Rogiel/ufrgs-instrumentacao-projeto/README.md

# ufrgs-instrumentacao-projeto
Relatório e outros conteúdos relacionados ao projeto final de Instrumentação
