Rogiel/ufrgs-instrumentacao-projeto/Resources/Images/Figuras.pptx

Dmáx

VINA_máx

0h2984

Rmáx

Vpontemáx

1.842mV

Tensão
de Saída
da Ponte

1.483V

Tmáx

119.4Ω

ΔR do
Pt100

Tensão
de Saída
do Amp.
de Instrum.
G=805

-1.823V

50°C

ΔT

ADC
14 bits
-5V a +5V

-10°C

Tmín

96.1Ω

Rmín

-2.265mV

Vpontemín

VINA_mín

0h1458

Dmín

Cadeia de medidas proposta – Termômetro

## Slide 2

Dmáx

VINA_máx

0h2978

Rmáx

Vpontemáx

1.9mV

Tensão
de Saída
da Ponte

1.476V

Tmáx

119.4Ω

ΔR do
Pt100

Tensão
de Saída
do Amp.
de Instrum.
G=805

-0.756V

50°C

ΔT

ADC
14 bits
-5V a +5V

Tmín

5°C

102.1Ω

Rmín

-0.8mV

Vpontemín

VINA_mín

0h1B2D

Dmín

Cadeia de medidas experimental – Termômetro

## Slide 3

Fiação para ligação ao circuito

Tubo plástico

Pt100

Fiação para ligação ao circuito

Silicone para isolamento

Pt100

Invólucro metálico

## Slide 4

Sensor
Efeito
Hall

Circuito
Condicionador

Filtro PB

ADC

Ferramenta de Instrumentação Virtual

## Slide 5

Pluvmáx

Cmáx

1115µs

Tmáx

8mm

Volmáx

203.6pF

ΔC do
Sensor

120mL

ΔVol

Período
do Oscilador

Índice
Pluviométrico

Volmín

0mL

3.416pF

Cmín

147µs

Tmín

Pluvmín

0mm

Cadeia de medidas proposta – Sensor de Nível

## Slide 6

Pluvmáx

Nmáx

8mm

Cmáx

117082 ciclos

Ciclosmáx

0.909

Volmáx

384.7pF

ΔC do
Sensor

120mL

ΔVol

Ciclos
do processador

Compensado
(Valor N)

Índice
Pluviométrico

Volmín

0mL

89.5pF

Cmín

35132 ciclos

Ciclosmín

0.004

Nmín

Pluvmín

0mm

Cadeia de medidas experimental – Sensor de Nível

## Slide 7

D=13.82cm

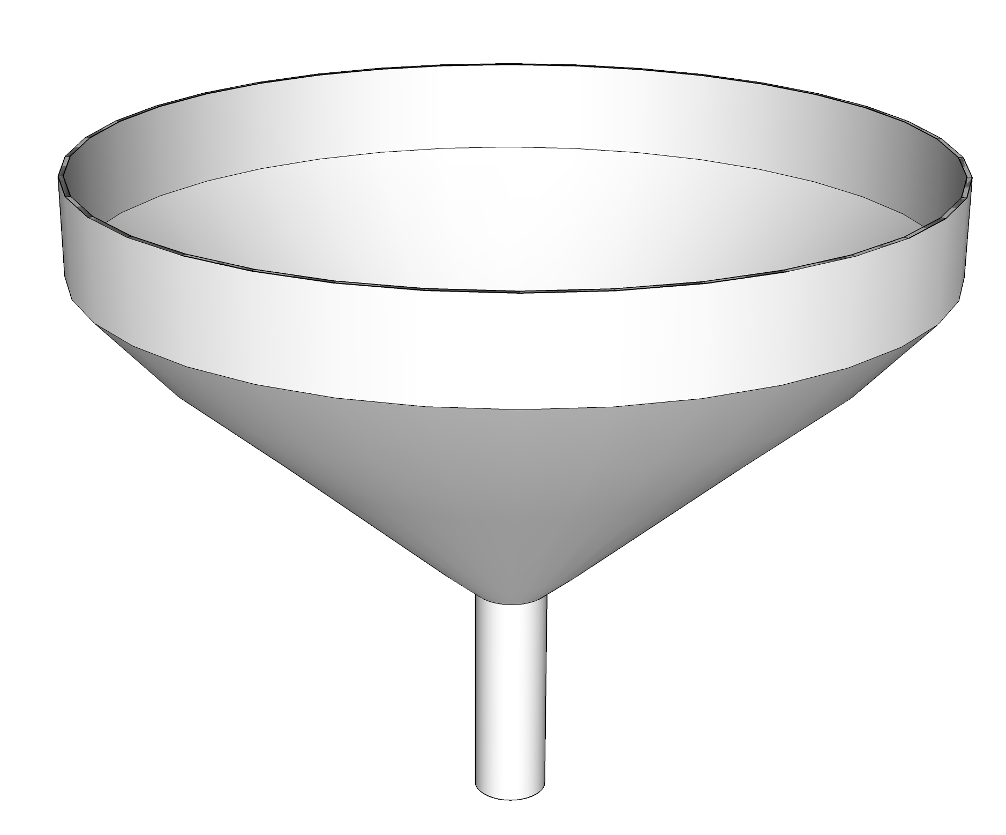
[picture p2: figure]

## Slide 8

RPMmáx

0h3FFF

ADC
14 bits
0V a +5V

Dmáx

RPMmáx

0h3FFF

ADC
14 bits
0V a +5V

Dmáx

Vmáx

796 RPM

Rotações
Da Estrutura

Vmáx

183.49 RPM

Rotações
Da Estrutura

Vento

15m/s

Vento

9.1m/s

3m/s

Vmín

159
RPM

RPMmín

2.9m/s

Vmín

83.33 RPM

0h0000

RPMmín

0h0000

Dmín

Dmín

Cadeia de medidas proposta – Anemômetro

Cadeia de medidas experimental – Anemômetro
