Rogiel/ufrgs-instrumentacao-projeto/Resources/Mathematica/Images/Nivel/Teorico/Capacitancia.pdf

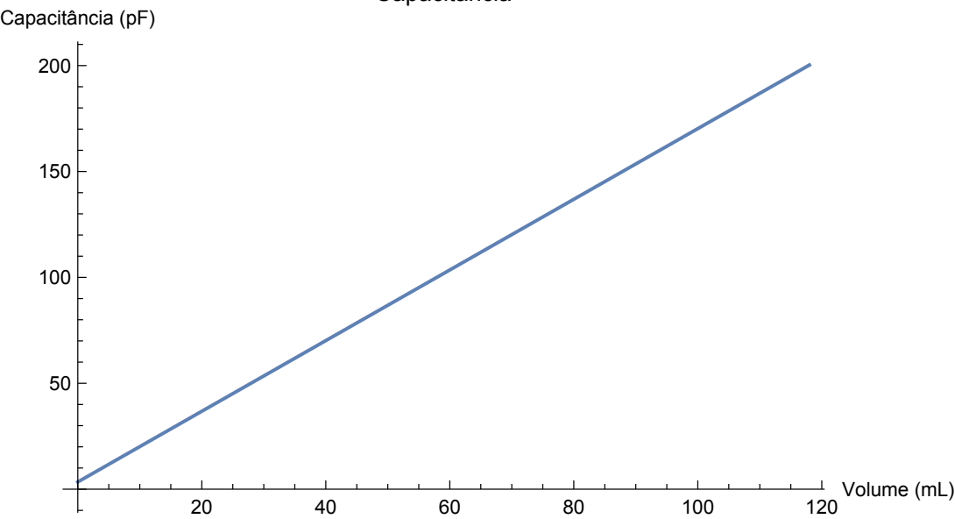
[picture p3: figure]
Volume (mL); Capacitância (pF)

### Capacitância
