Rogiel/ufrgs-instrumentacao-projeto/Resources/Images/SensorNivelCapacitivo.pdf

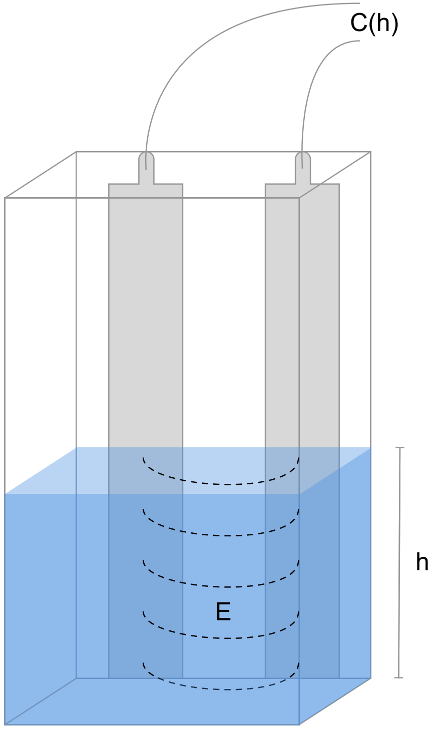
[picture p4: figure]
