Rogiel/ufrgs-instrumentacao-projeto/Resources/Mathematica/Images/Nivel/Teorico/Ciclos.pdf

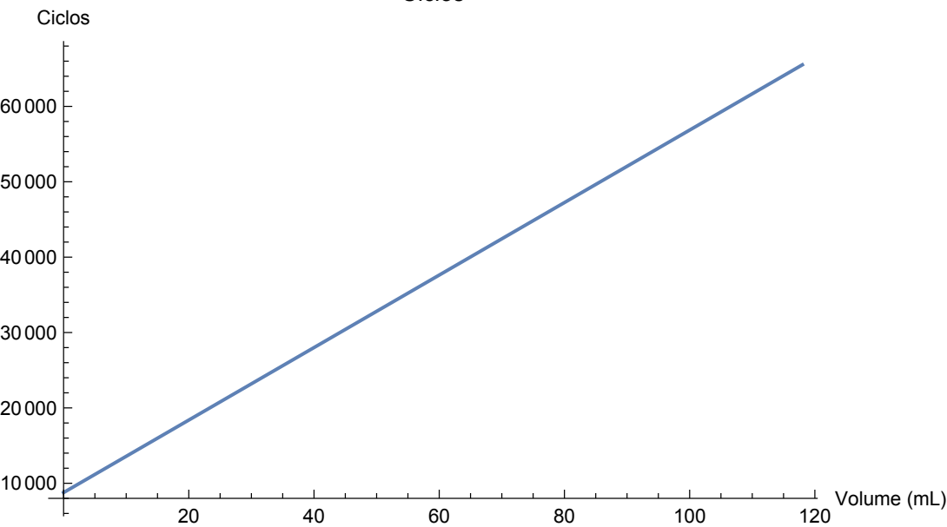
[picture p5: figure]
Volume (mL); Ciclos

### Ciclos
