Rogiel/ufrgs-instrumentacao-projeto/Resources/Mathematica/Images/Nivel/Teorico/Compensado.pdf

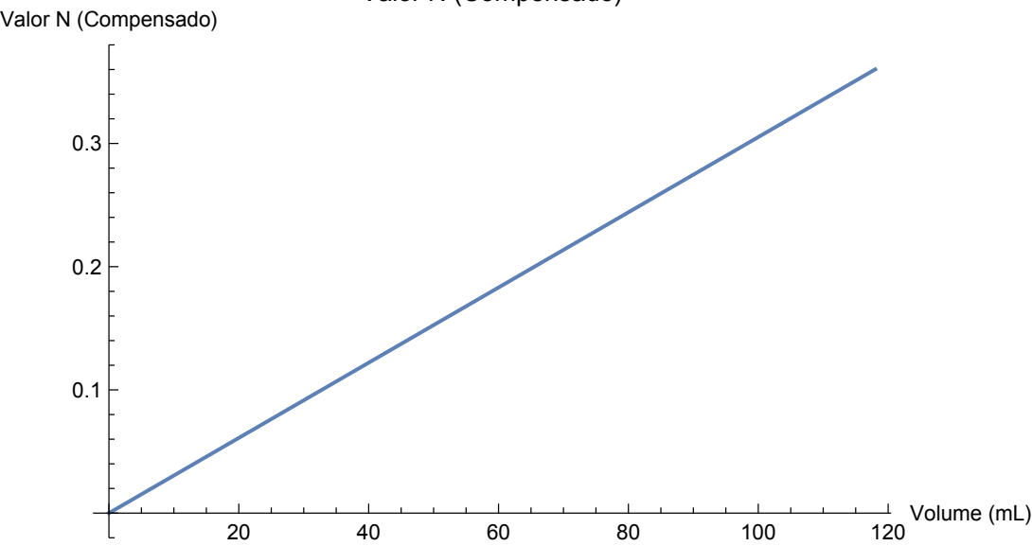
[picture p6: figure]
Volume (mL); Valor N (Compensado)

### Valor N (Compensado)
