Rogiel/ufrgs-instrumentacao-projeto/Resources/Mathematica/Images/Nivel/Teorico/Frequencia-Sensibilidade.pdf

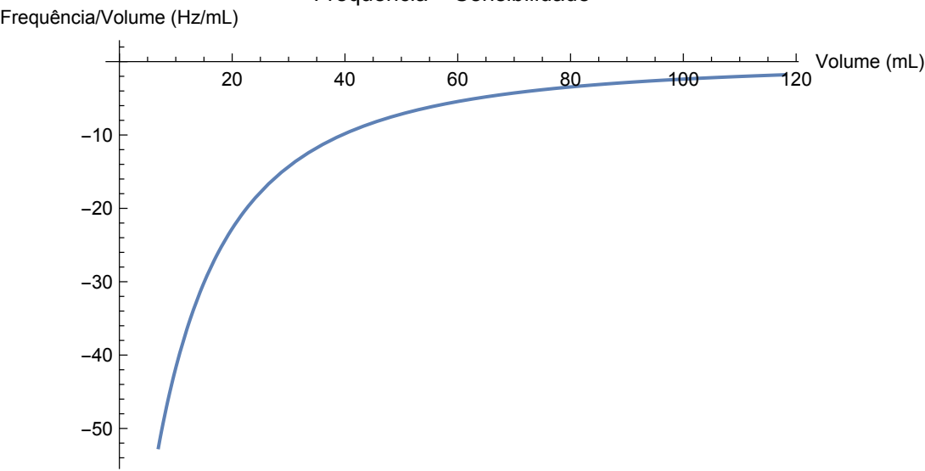
[picture p7: figure]
Volume (mL); Frequência/Volume (Hz/mL)

### Frequência - Sensibilidade
