Rogiel/ufrgs-instrumentacao-projeto/Resources/Mathematica/Images/Nivel/Teorico/Frequencia.pdf

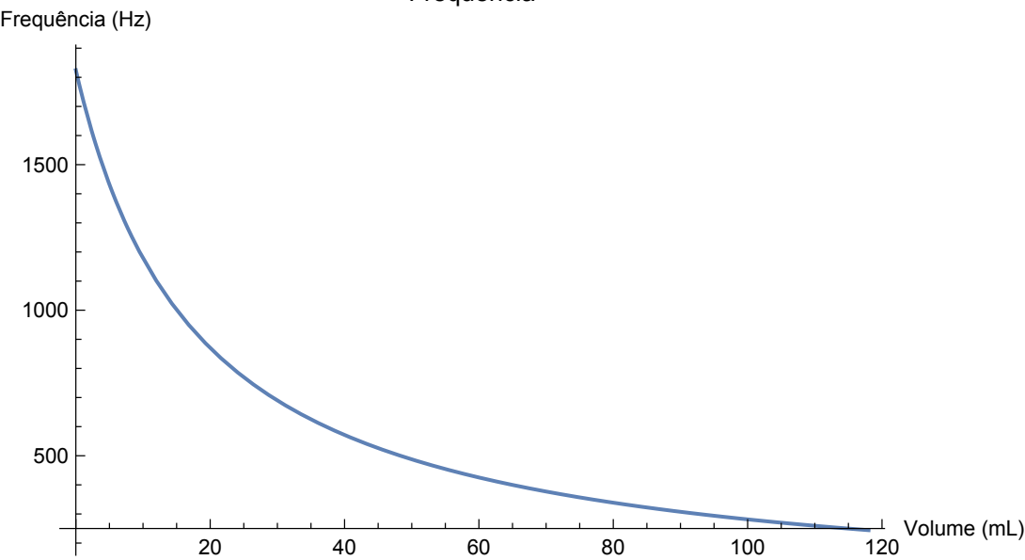
[picture p8: figure]
Volume (mL); Frequência (Hz)

### Frequência
