Rogiel/ufrgs-instrumentacao-projeto/Resources/Images/anemometro-bloco-hall.jpg

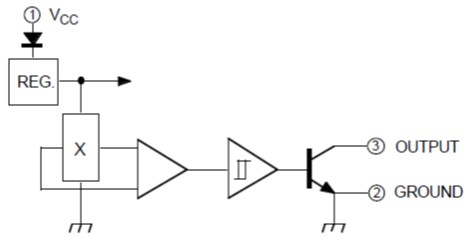
Resources/Images/anemometro-bloco-hall.jpg
