Rogiel/ufrgs-instrumentacao-projeto/Resources/Images/anemometro-cadeia-medidas-proposta.jpg

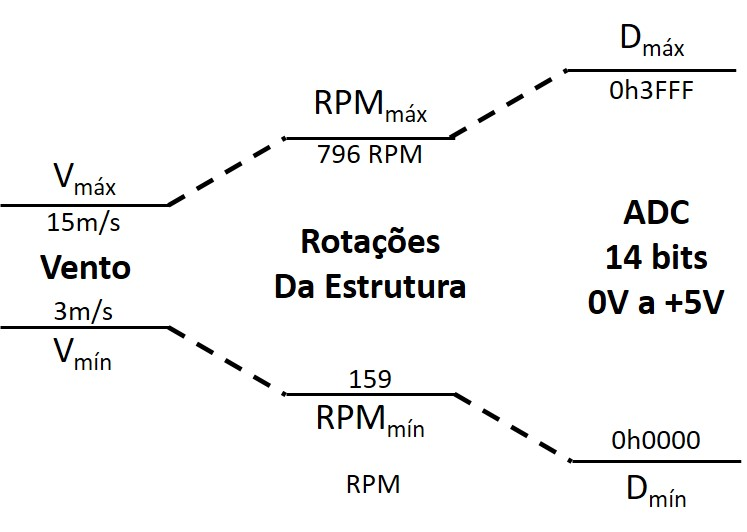
Resources/Images/anemometro-cadeia-medidas-proposta.jpg
