Rogiel/ufrgs-instrumentacao-projeto/Resources/Images/anemometro-fluxograma.jpg

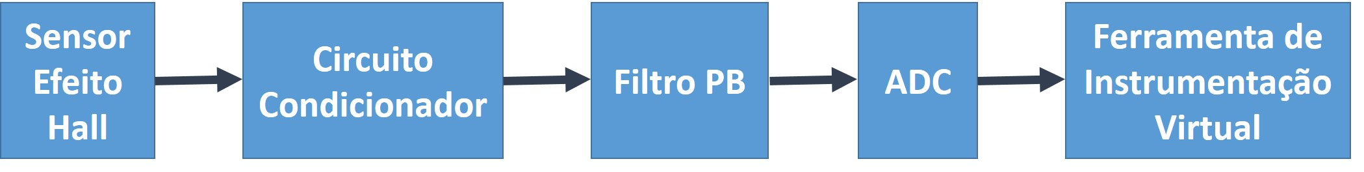
Resources/Images/anemometro-fluxograma.jpg
