Rogiel/ufrgs-instrumentacao-projeto/Resources/Images/anemometro-ilustracao.jpg

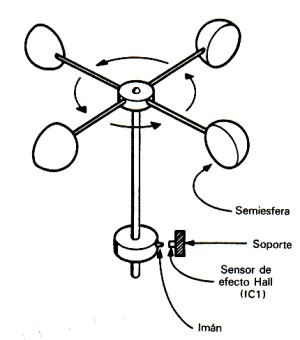
Resources/Images/anemometro-ilustracao.jpg
