Rogiel/ufrgs-instrumentacao-projeto/Resources/Images/hall-circuito.png

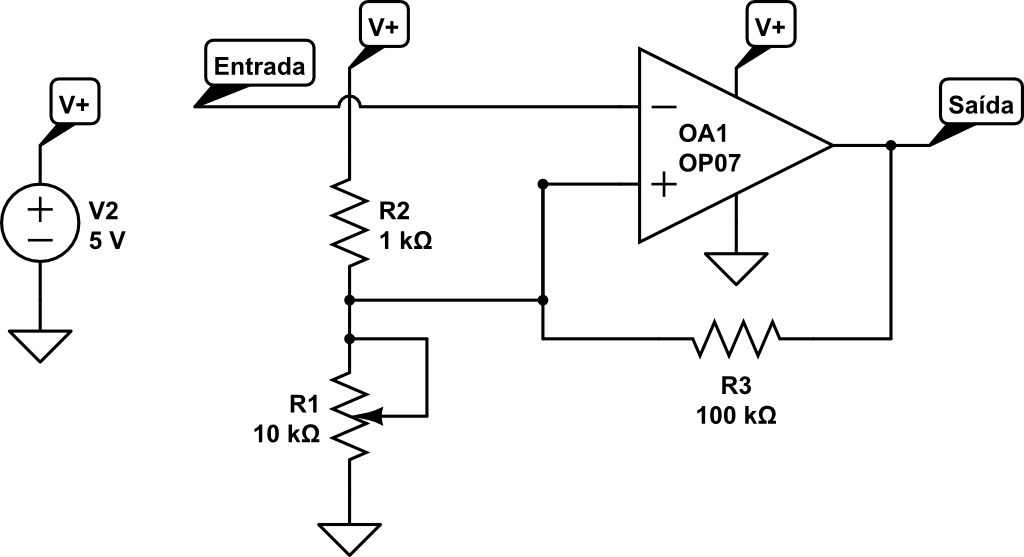
Resources/Images/hall-circuito.png
