Rogiel/ufrgs-instrumentacao-projeto/Resources/Images/pluviometro-cadeia-medidas-proposta.jpg

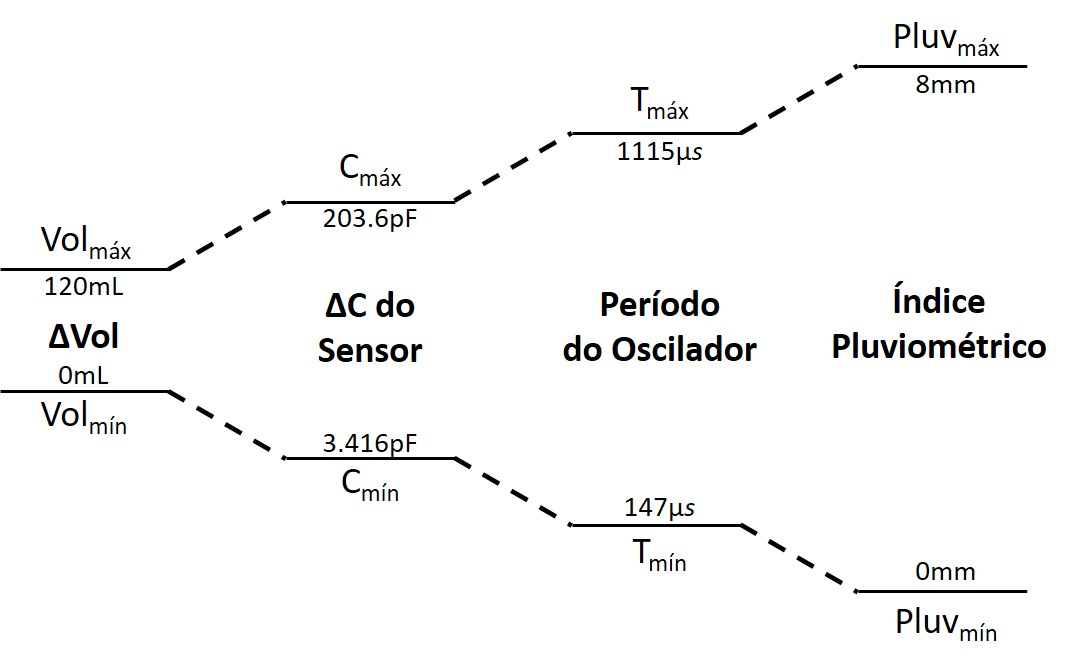
Resources/Images/pluviometro-cadeia-medidas-proposta.jpg
