Rogiel/ufrgs-instrumentacao-projeto/Resources/Images/pluviometro_funil.jpg

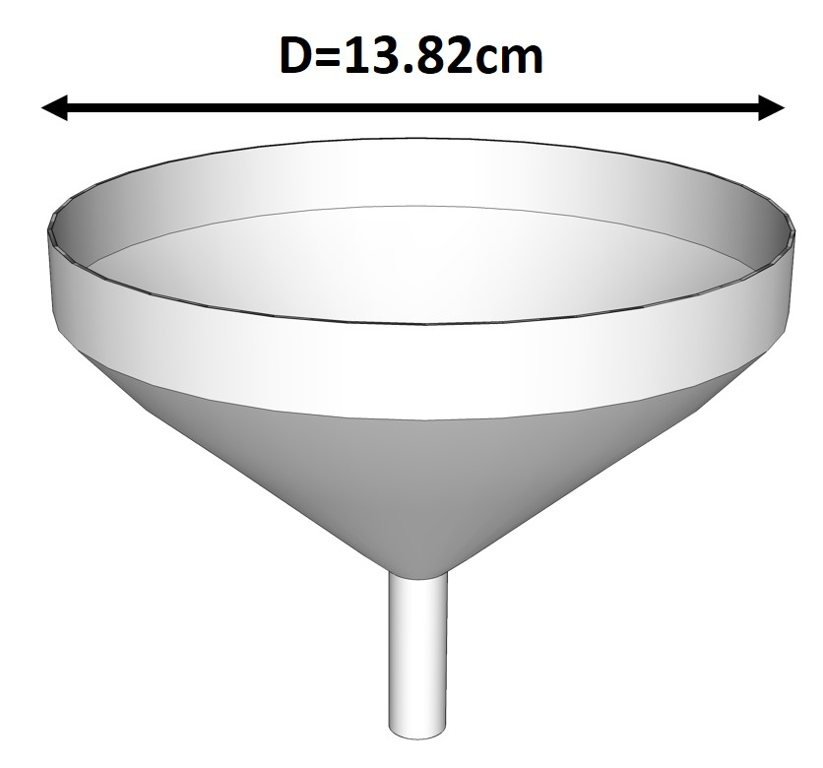
Resources/Images/pluviometro_funil.jpg
