Rogiel/ufrgs-instrumentacao-projeto/Resources/Images/pt100-condicionamento-completo.png

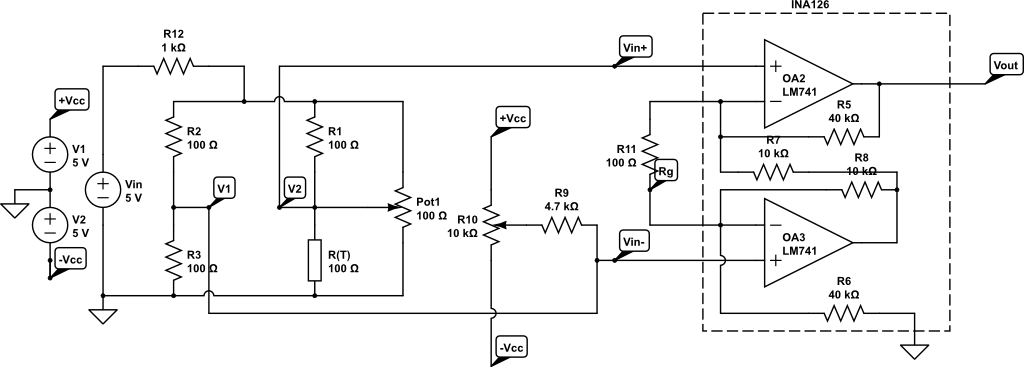
Resources/Images/pt100-condicionamento-completo.png
