Rogiel/ufrgs-instrumentacao-projeto/Resources/Images/pt100-ponte-balanco.png

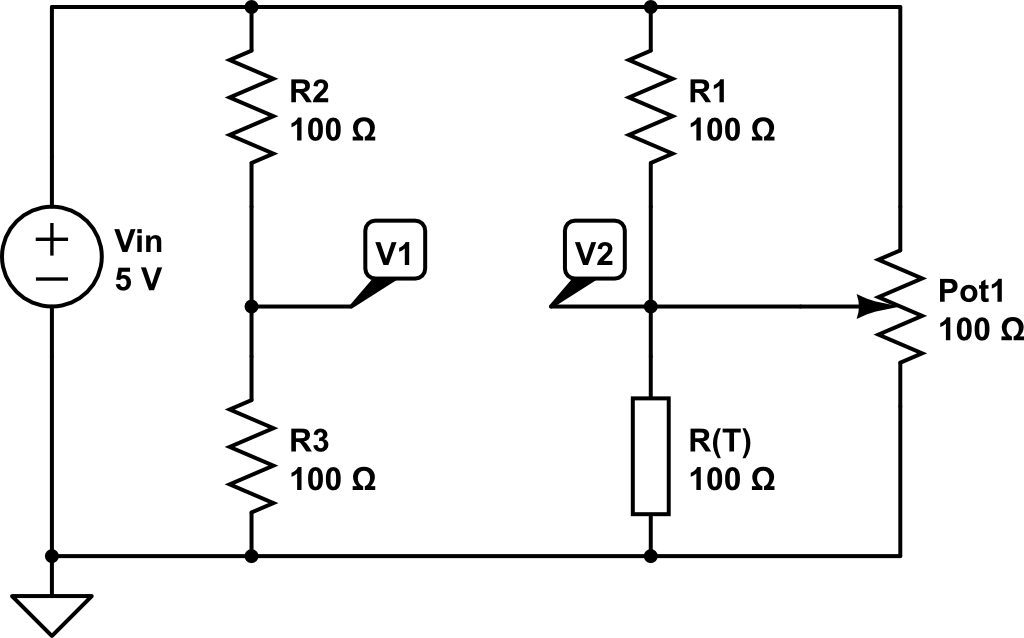
Resources/Images/pt100-ponte-balanco.png
