Rogiel/ufrgs-instrumentacao-projeto/Resources/Images/pt100-ponte-com-ina-max.png

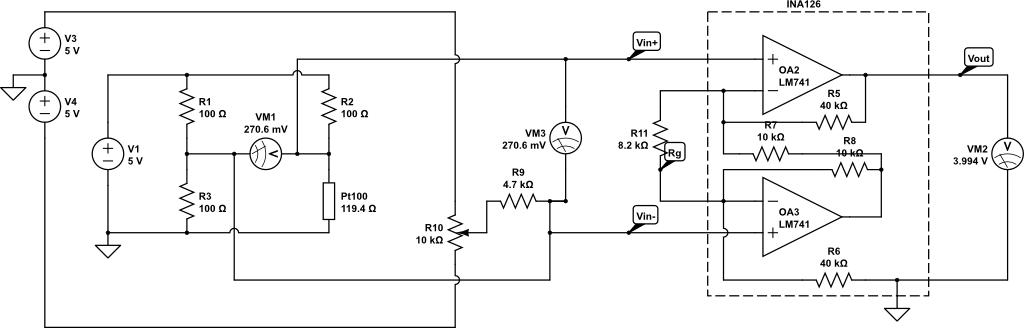
Resources/Images/pt100-ponte-com-ina-max.png
