Rogiel/ufrgs-instrumentacao-projeto/Resources/Images/pt100-ponte-offset.png

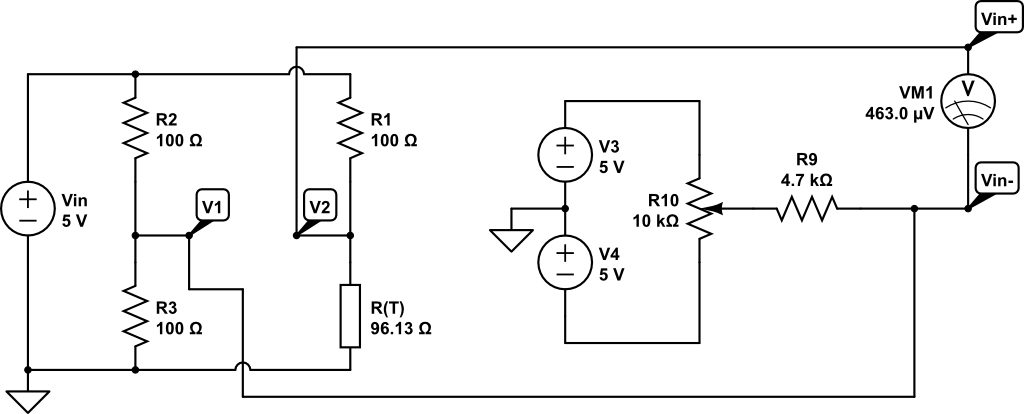
Resources/Images/pt100-ponte-offset.png
