Rogiel/ufrgs-instrumentacao-projeto/Resources/Images/pt100-ponte.png

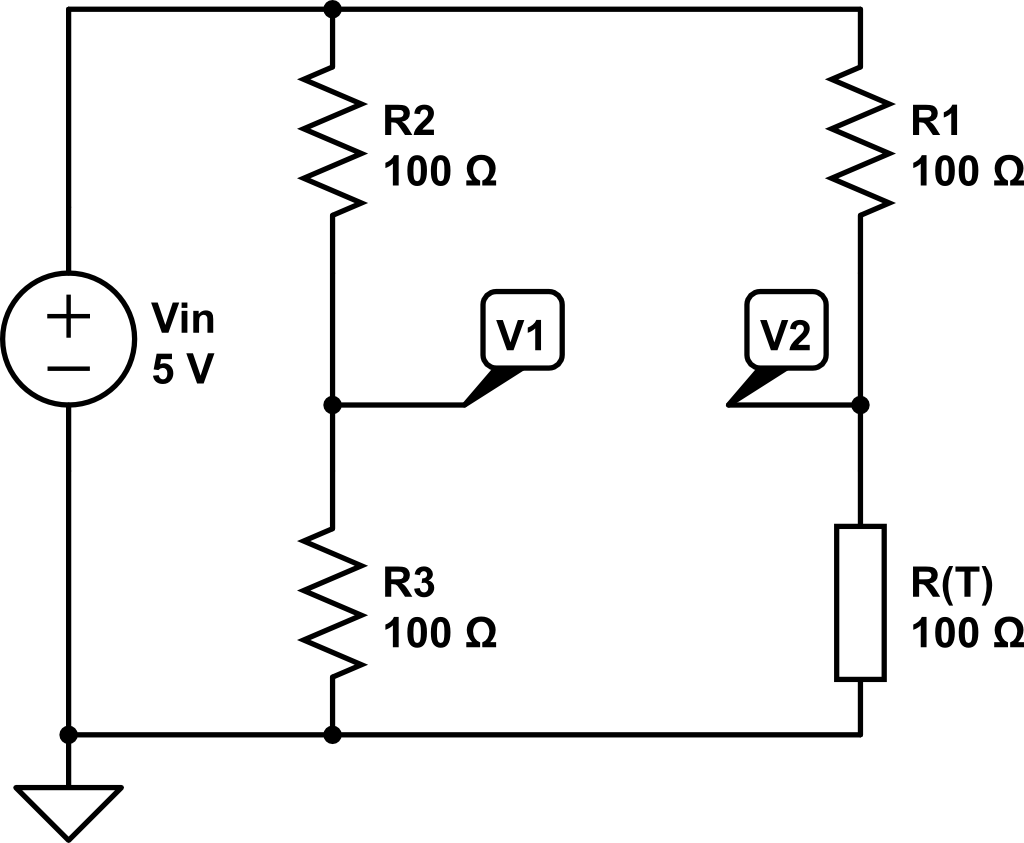
Resources/Images/pt100-ponte.png
