Rogiel/ufrgs-instrumentacao-projeto/Resources/Images/sensor-hall-foto.jpg

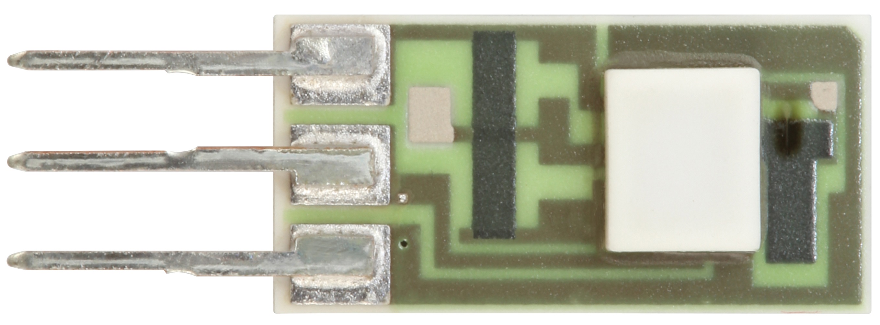
Resources/Images/sensor-hall-foto.jpg
