Rogiel/ufrgs-instrumentacao-projeto/Resources/Images/SensorNivelCapacitivo-Condicionamento.jpg

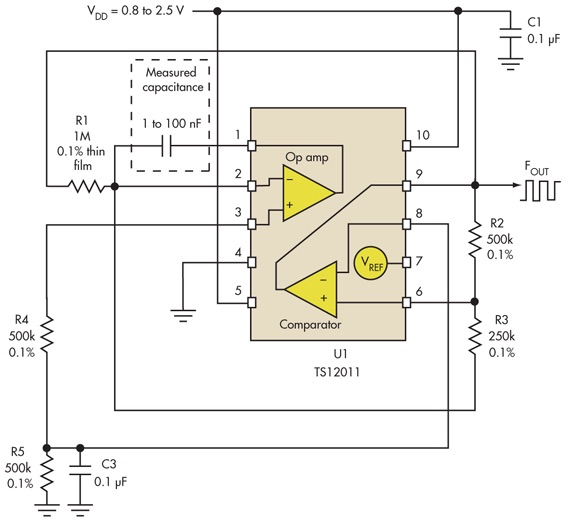
Resources/Images/SensorNivelCapacitivo-Condicionamento.jpg
