Rogiel/ufrgs-instrumentacao-projeto/Resources/Images/termometro-cadeia-medidas-proposta2.jpg

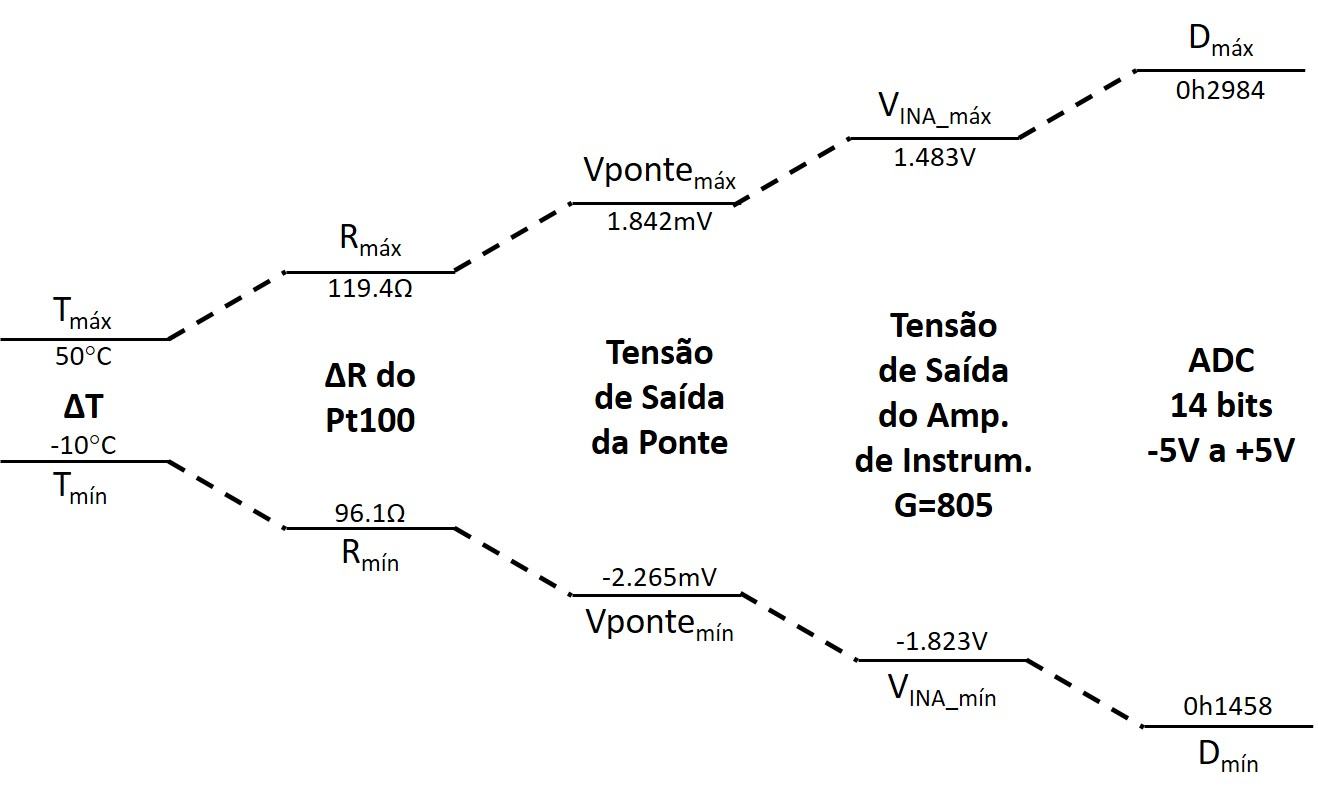
Resources/Images/termometro-cadeia-medidas-proposta2.jpg
