Rogiel/ufrgs-instrumentacao-projeto/Resources/Images/termometro-cadeia-medidas-proposta.jpg

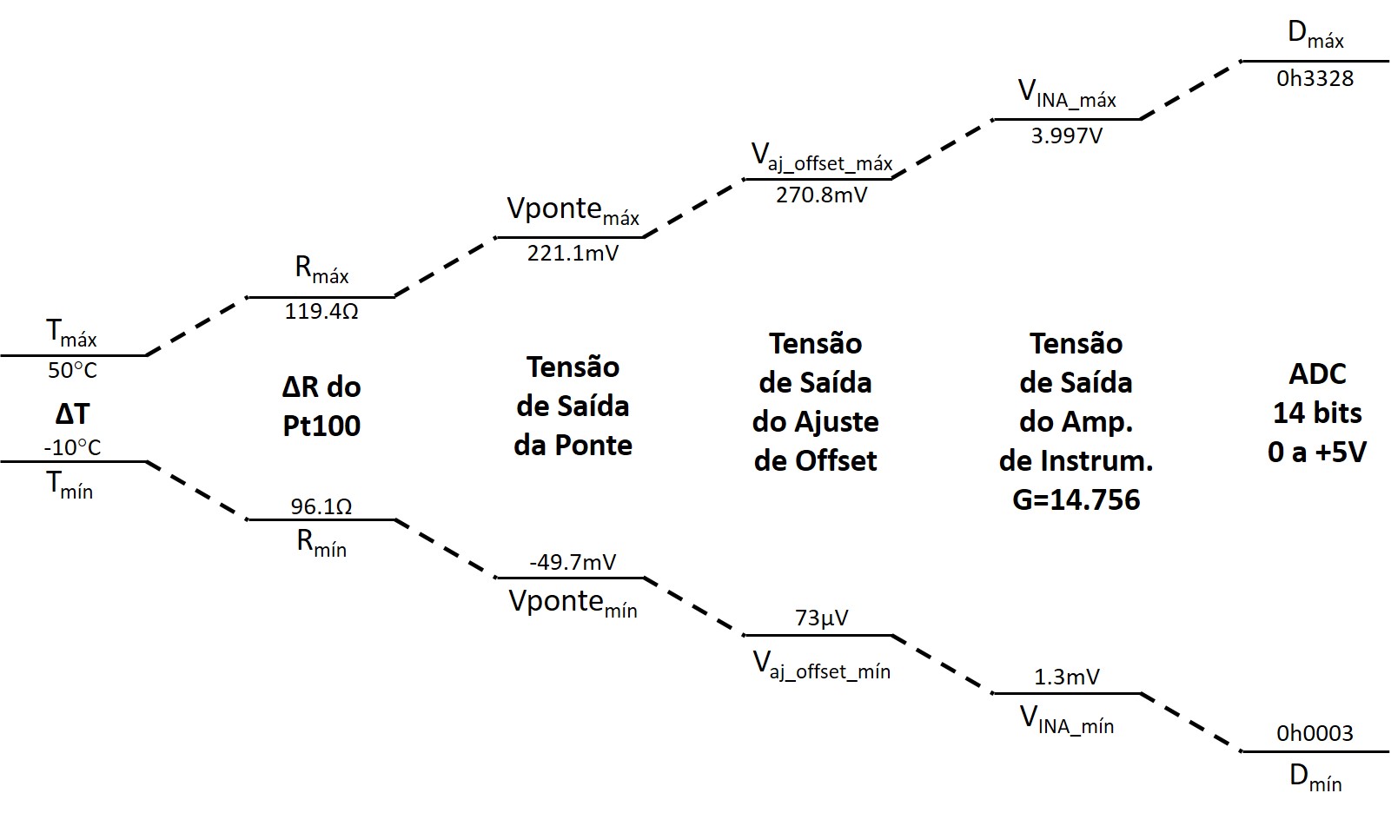
Resources/Images/termometro-cadeia-medidas-proposta.jpg
