Rogiel/ufrgs-instrumentacao-projeto/Resources/Images/termometro-ilustracao2.jpg

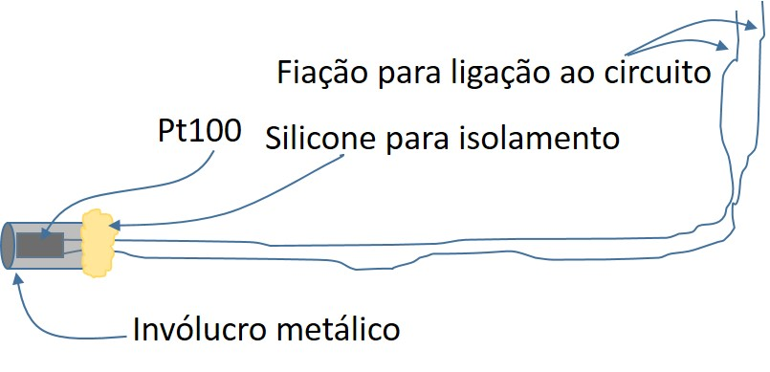
Resources/Images/termometro-ilustracao2.jpg
