Rogiel/ufrgs-instrumentacao-projeto/Resources/Images/termometro-ilustracao.jpg

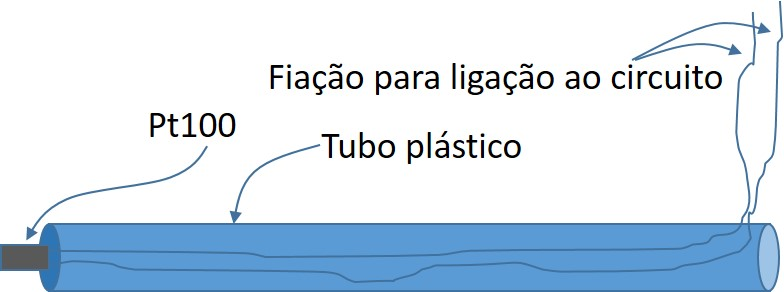
Resources/Images/termometro-ilustracao.jpg
