Rogiel/ufrgs-instrumentacao-projeto/Resources/Images/Pluviometro-Experimental-Capacitancia.pdf

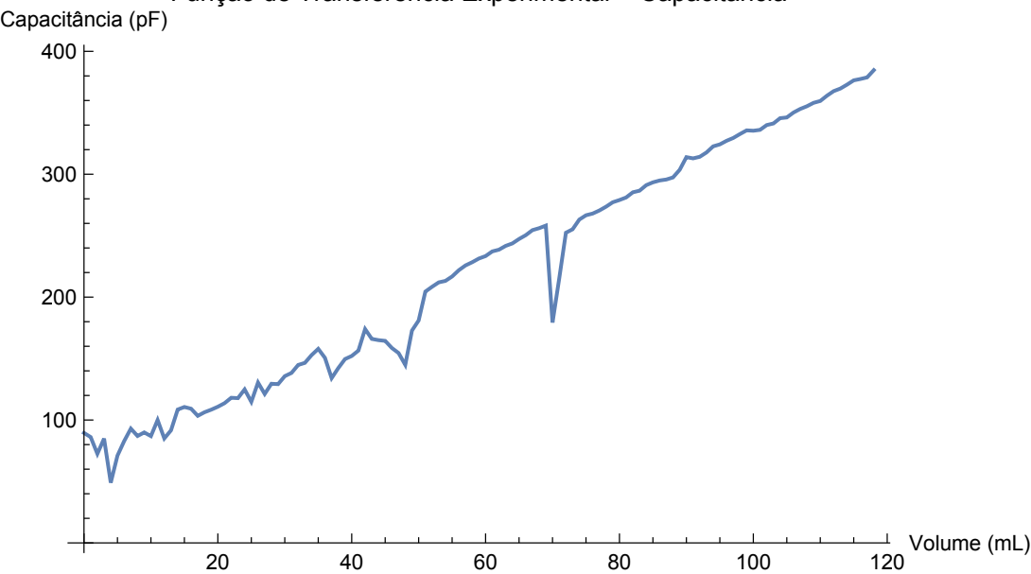
[picture p27: figure]
Volume (mL); Capacitância (pF)

### Função de Transferência Experimental - Capacitância
