Rogiel/ufrgs-instrumentacao-projeto/Resources/Mathematica/Images/Nivel/Experimental/Capacitancia.pdf

Volume (mL); Capacitância (pF)

### Função de Transferência Experimental - Capacitância
