Rogiel/ufrgs-instrumentacao-projeto/Resources/Mathematica/Images/Nivel/Experimental/Ciclos.pdf

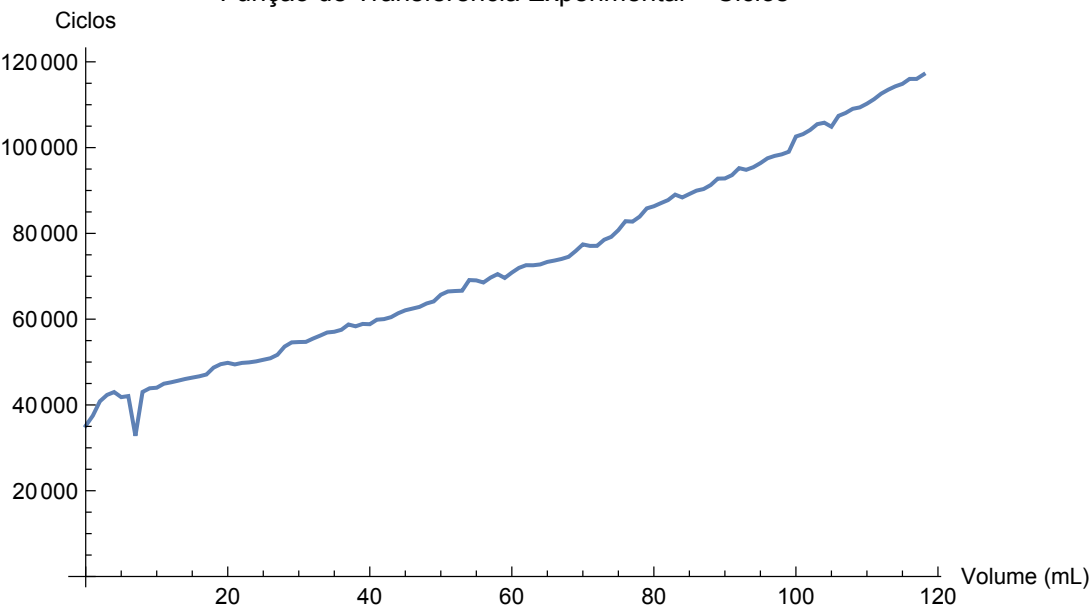
[picture p28: figure]
Volume (mL); Ciclos

### Função de Transferência Experimental - Ciclos
