Rogiel/ufrgs-instrumentacao-projeto/Resources/Mathematica/Images/Nivel/Experimental/Compensado.pdf

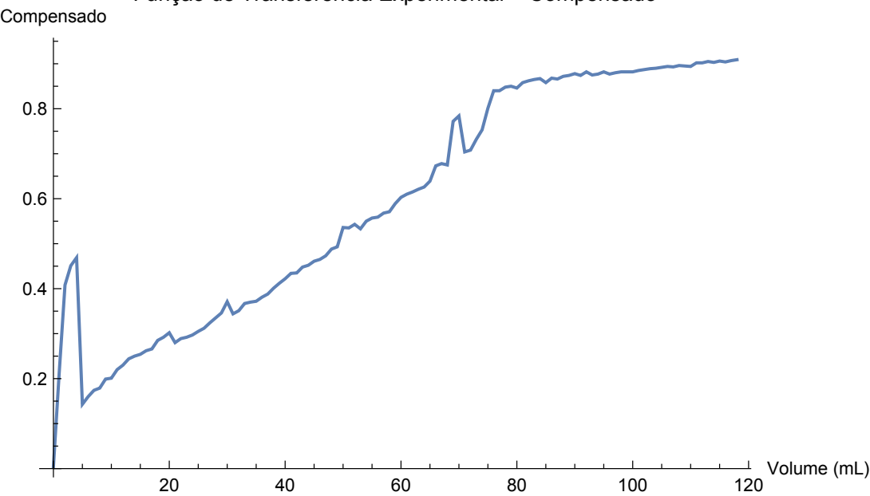
[picture p29: figure]
Volume (mL); Compensado

### Função de Transferência Experimental - Compensado
