Rogiel/ufrgs-instrumentacao-projeto/Resources/Mathematica/Images/Nivel/Experimental/Frequencia.pdf

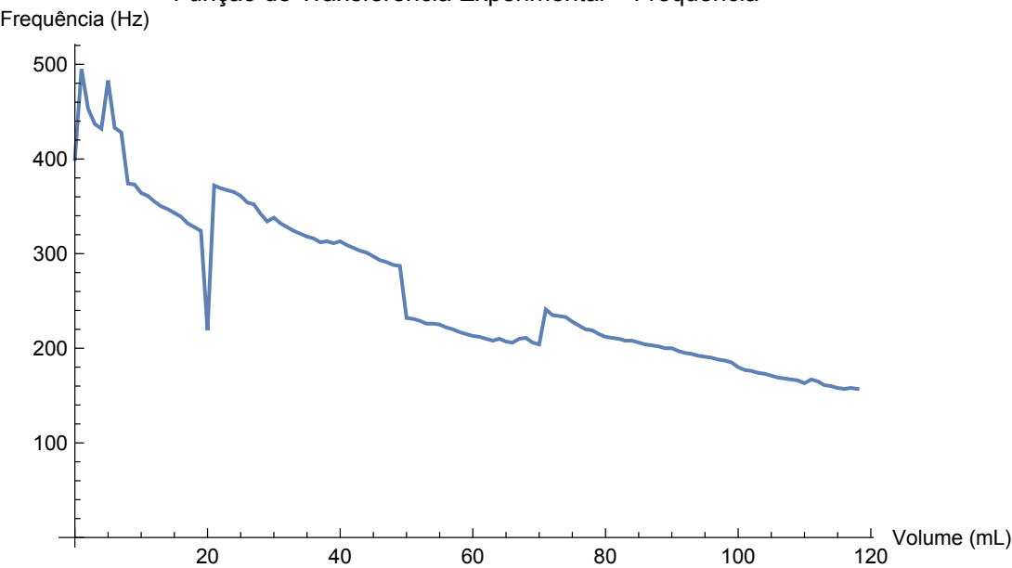
[picture p30: figure]
Volume (mL); Frequência (Hz)

### Função de Transferência Experimental - Frequência
