Rogiel/ufrgs-instrumentacao-projeto/Resources/Mathematica/Images/Nivel/Experimental/Capacitancia-Ajuste.pdf

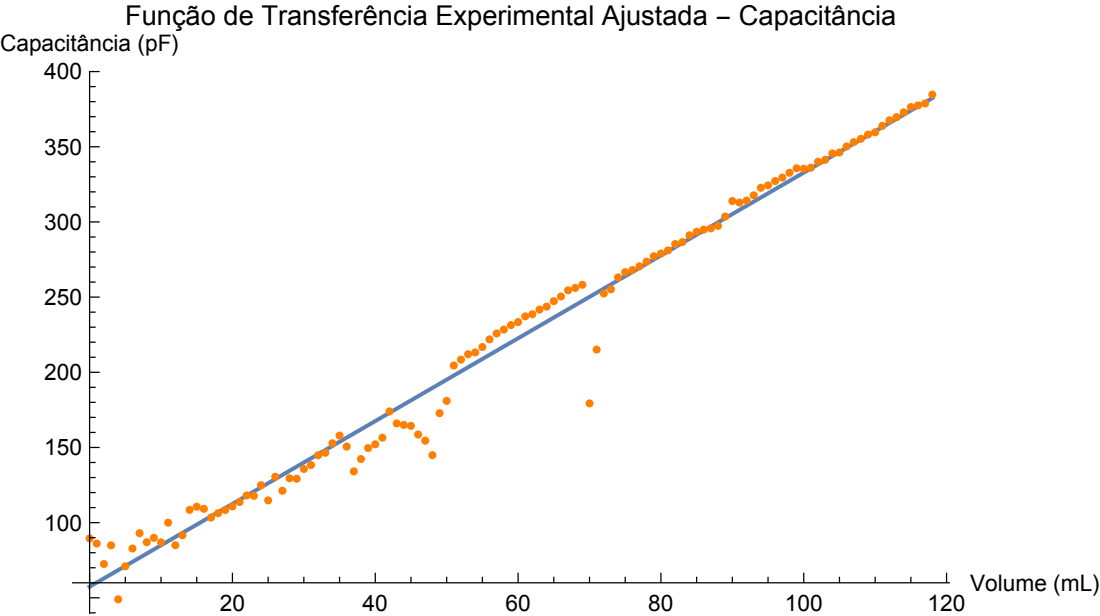
[picture p31: page 1]
Volume (mL); Capacitância (pF)

Função de Transferência Experimental Ajustada - Capacitância
