Rogiel/ufrgs-instrumentacao-projeto/Resources/Mathematica/Images/Nivel/Experimental/Capacitancia-Comparacao.pdf

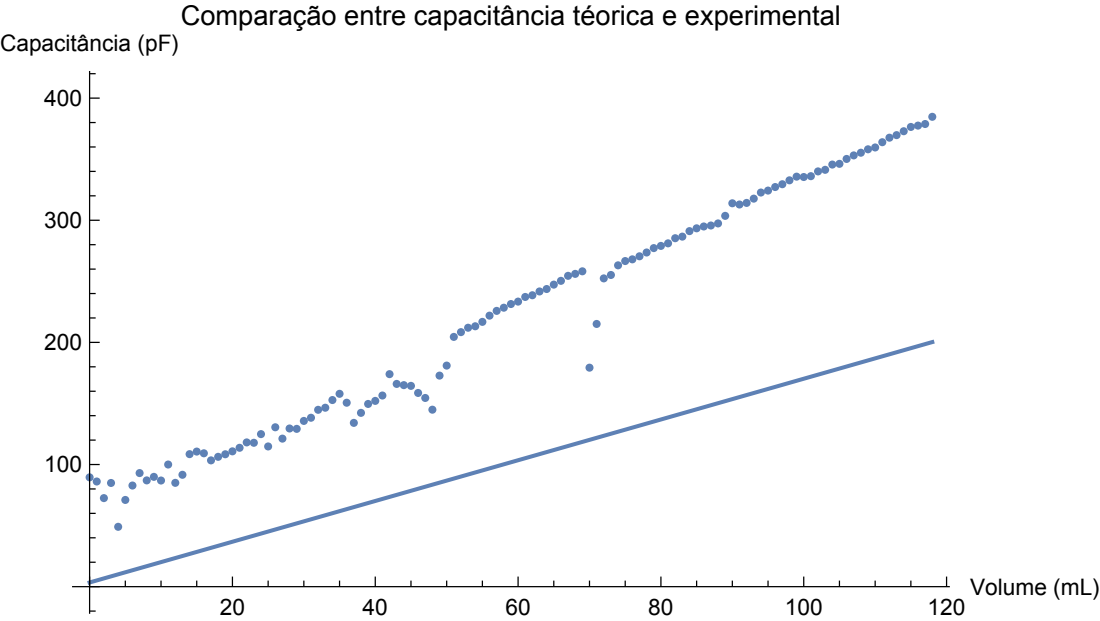
[picture p32: page 1]
Volume (mL); Capacitância (pF)

Comparação entre capacitância téorica e experimental
