Rogiel/ufrgs-instrumentacao-projeto/Resources/Images/Circuitos/Pluviometro-Oscilador.pdf

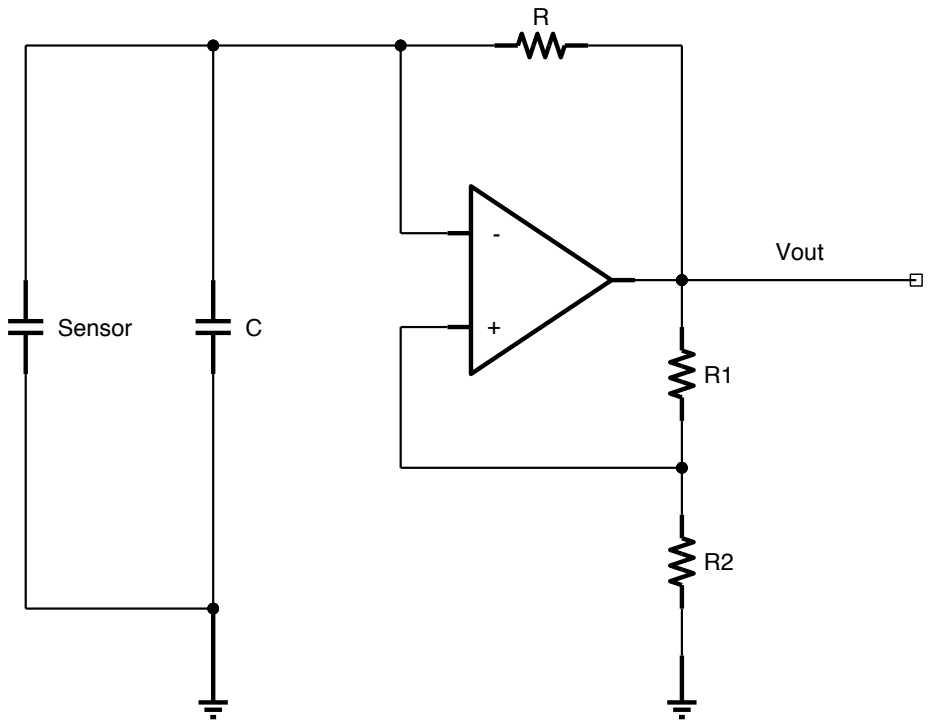
[picture p33: page 1]
Sensor; Vout
