Rogiel/ufrgs-instrumentacao-projeto/Resources/Mathematica/Images/Temperatura/ConditionatedTransferFunction.pdf

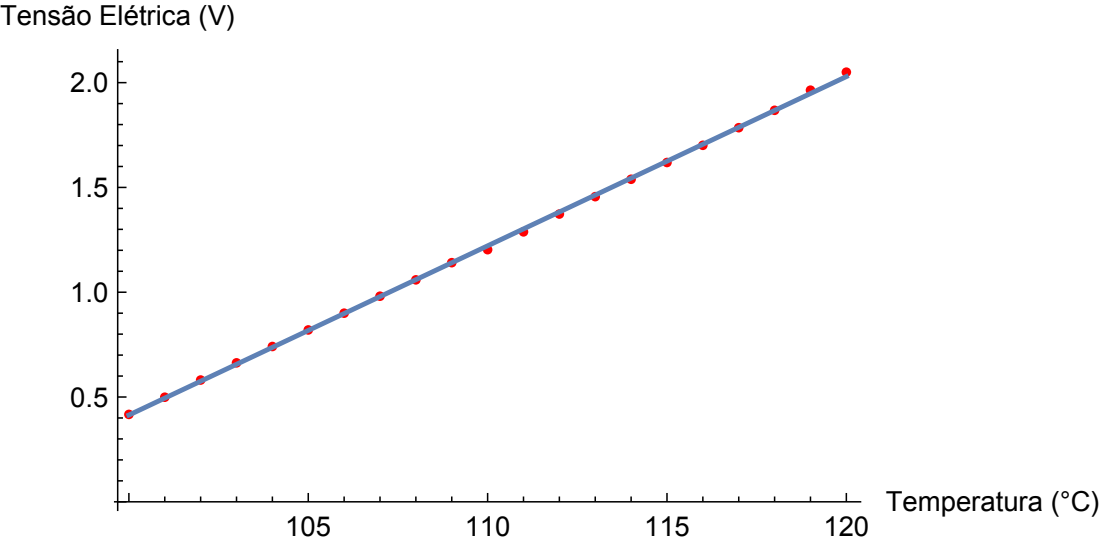
[picture p34: page 1]
120 Temperatura (°C); Tensão Elétrica (V)
