Rogiel/ufrgs-instrumentacao-projeto/Resources/Mathematica/Images/Temperatura/ResistenceTransferFunction.pdf

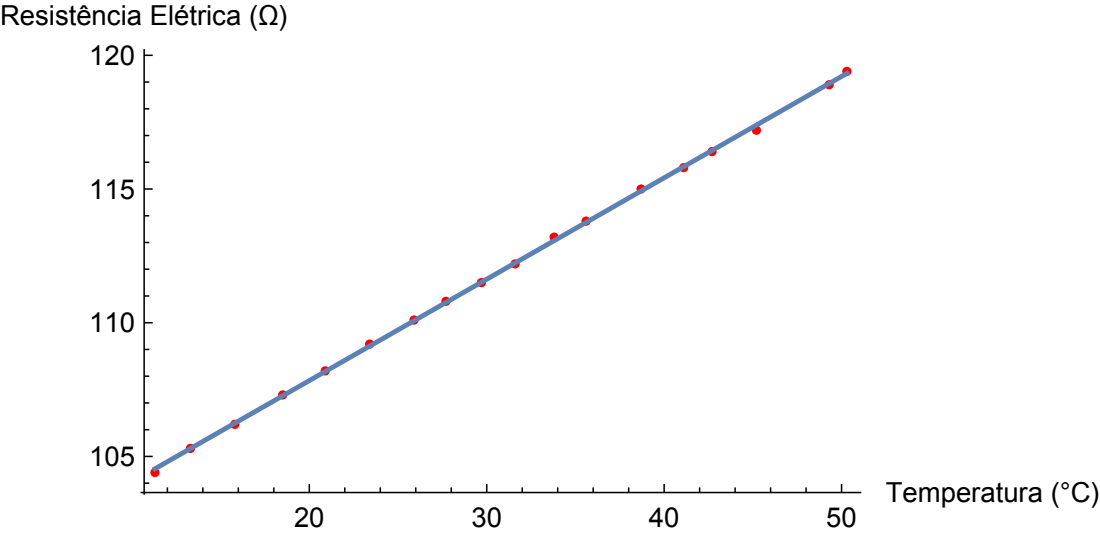
[picture p35: page 1]
50 Temperatura (°C); Resistência Elétrica (Ω)
