Rogiel/ufrgs-instrumentacao-projeto/Resources/Mathematica/Images/Nivel/Experimental/Ciclos-Ajuste.pdf

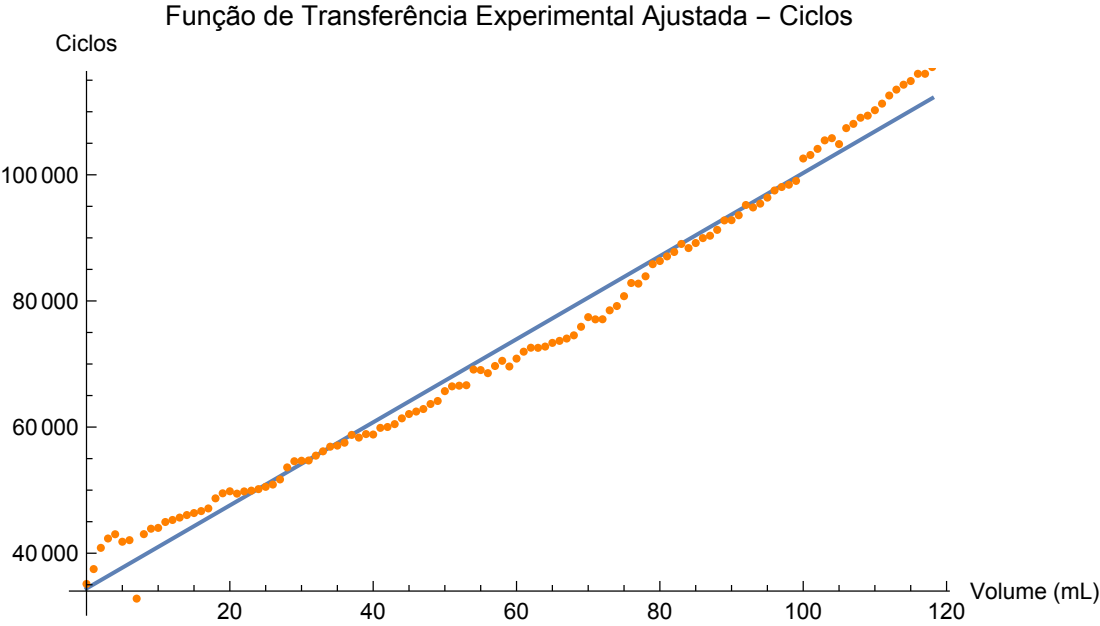
[picture p36: page 1]
Volume (mL); Ciclos

Função de Transferência Experimental Ajustada - Ciclos
