Rogiel/ufrgs-instrumentacao-projeto/Resources/Mathematica/Images/Nivel/Experimental/Compensado-Ajuste.pdf

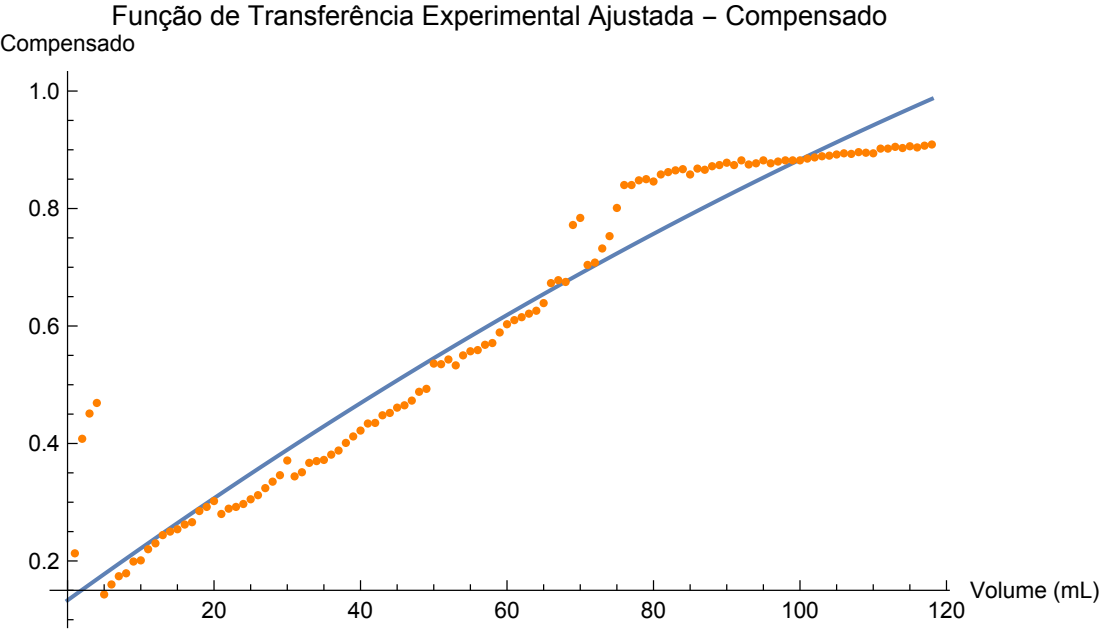
[picture p37: page 1]
Volume (mL); Compensado

Função de Transferência Experimental Ajustada - Compensado
