Rogiel/ufrgs-instrumentacao-projeto/Resources/Mathematica/Images/Nivel/Experimental/Frequencia-Ajuste.pdf

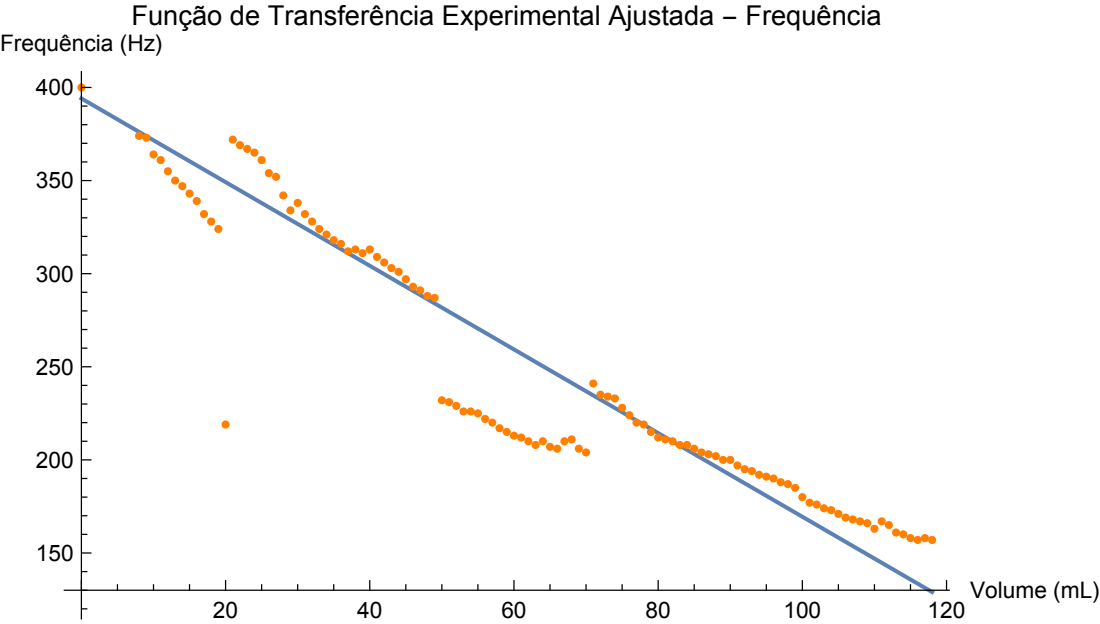
[picture p38: page 1]
Volume (mL); Frequência (Hz)

Função de Transferência Experimental Ajustada - Frequência
