Rogiel/ufrgs-instrumentacao-projeto/Resources/Mathematica/Images/Nivel/Experimental/Ciclos-Comparacao.pdf

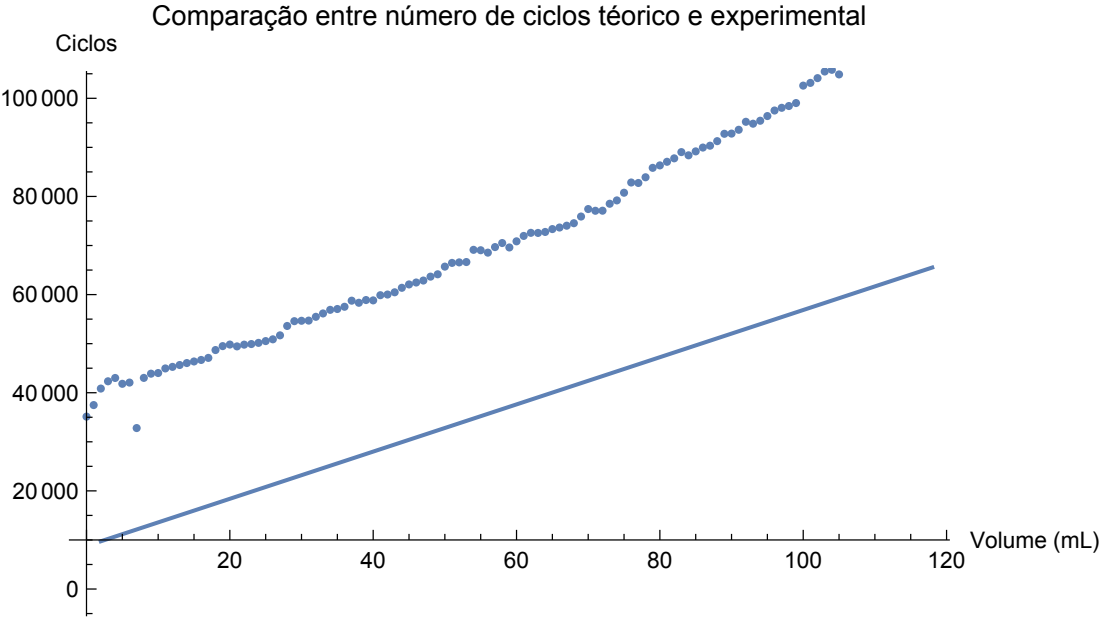
[picture p39: page 1]
Volume (mL); Ciclos

Comparação entre número de ciclos téorico e experimental
