Rogiel/ufrgs-instrumentacao-projeto/Resources/Mathematica/Images/Nivel/Experimental/Compensado-Comparacao.pdf

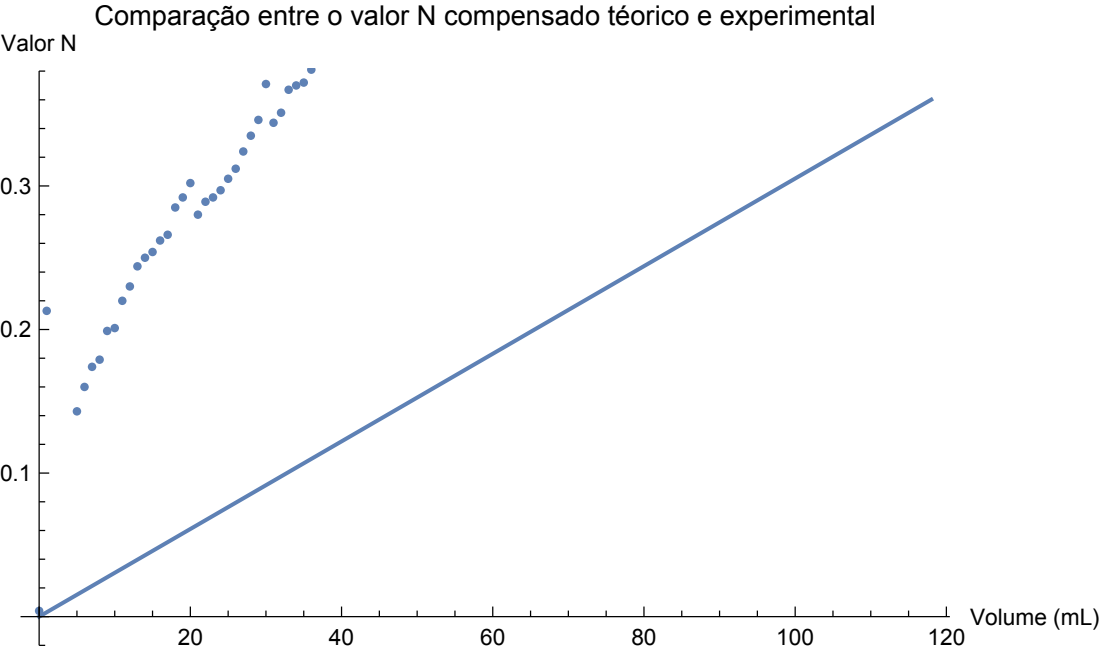
[picture p40: page 1]
Volume (mL); Valor N

Comparação entre o valor N compensado téorico e experimental
