Rogiel/ufrgs-instrumentacao-projeto/Resources/Mathematica/Images/Nivel/Experimental/Frequencia-Comparacao.pdf

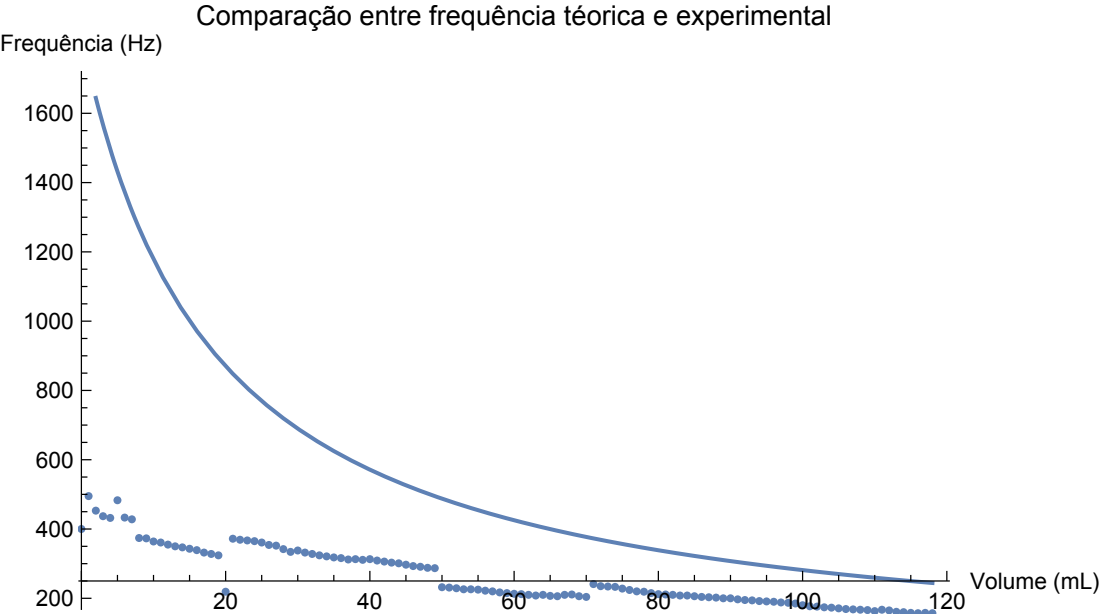
[picture p41: page 1]
Volume (mL) 200; Frequência (Hz)

Comparação entre frequência téorica e experimental
