Rogiel/ufrgs-instrumentacao-projeto/(list of files, drawings)

Other design files:
Resources/Altium/Placa/Condicionamento - Temperatura.SchDoc
Resources/Altium/Placa/IO.SchDoc
Resources/Altium/Placa/PCB1.PcbDoc
Resources/Altium/Placa/Placa.PrjPcb
Resources/Altium/Sensor de Nivel/Condicionamento.SchDoc
Resources/Altium/Sensor de Nivel/Sensor de Nivel.PrjPcb
Resources/Altium/Sensor de Nivel/Sensor.PcbDoc
Resources/Proteus/Hall.pdsprj
Resources/Proteus/Sensor de Nivel.pdsprj
Resources/Proteus/Termometro.pdsprj
