Rogiel/ufrgs-instrumentacao-projeto/(commit log)

2016-04-18 Rogiel - Dê uma olhada se ficou bom
    Falta apenas decidir o sensor de temperatura e terminar de escreve a
    parte de termometro e traduzir o resumo
2016-04-18 Corrigida a escrita de alguns trechos da proposta
2016-06-05 Adicionado texto no anteprojeto
    Conflicts:
    Relatório/Anteprojeto.tex
    [Condicionamento - Temperatura.SchDoc, IO.SchDoc, PCB1.PcbDoc, Placa.PrjPcb, Sensor de Nivel.PrjPcb, Sensor.PcbDoc]
2016-06-05 Aicionadas medidas iniciais
    [Medidas Iniciais.xlsx]
2016-06-05 Adicionado PDFs com referências e datasheets
2016-06-05 Adicionado cálculos feitos até o momento
2016-06-06 pt100 imagens circuito
    [Medidas Iniciais.xlsx]
2016-06-06 Adicionado comentário sobre as dimensões do recipiente
    [Medidas Iniciais.xlsx]
2016-06-06 Atualizada legenda dos eixos dos gráficos para o Pt100
2016-06-06 Metodologia e Resultados Termometro OK
    [Medidas Iniciais.xlsx]
2016-06-15 Adicionado software de medição da capacitância
    [Condicionamento.SchDoc, Placa.PrjPcb, Sensor de Nivel.PrjPcb, Sensor de Nivel.pdsprj, Termometro.pdsprj]
2016-06-15 Adicionado projetos das placas
    [Sensor de Nivel.pdsprj, Termometro.pdsprj]
2016-06-18 Finalizada as placas do sensor de temperatura e nível e software do microcontrolador embarcado do condicionamento do sensor de nivel
    [Sensor de Nivel.pdsprj, Termometro.pdsprj]
2016-06-22 Adicionado código da interface gráfica
    [Hall.pdsprj]
2016-06-25 Atualizado software da IHM
    [Termometro.pdsprj]
2016-06-25 Clona o anteprojeto como base inicial para o relatório
2016-06-25 Adicionado discussão sobre a metodologia experimental do sensor de nível
2016-06-25 Adicionado tabelas de medidas
2016-06-25 medidas iniciais
    [Medidas Iniciais.xlsx]
2016-06-25 Adicionado desenvolvimento teórico da capacitância
2016-06-26 Adicionado detalhes sobre erro de linearidade do sensor de nivel
2016-06-26 Corrigido português
    [Sensor de Nivel.pdsprj]
2016-06-26 Adicionado cálculo de sensibilidade experimental
2016-06-27 resultados termometro OK
    [Medidas Iniciais.xlsx]
2016-06-27 Resultados Anemometro
    [Medidas Iniciais.xlsx]
2016-06-27 Alterado scripts de cálculo
2016-06-27 mais ajustes
    [Medidas Iniciais.xlsx]
2016-06-27 Atualizada traduçao do resumo
